Chenchen-0506/esp32-s4-fly/groundstation/_shots/S4Fly地面站_desktop.jpg

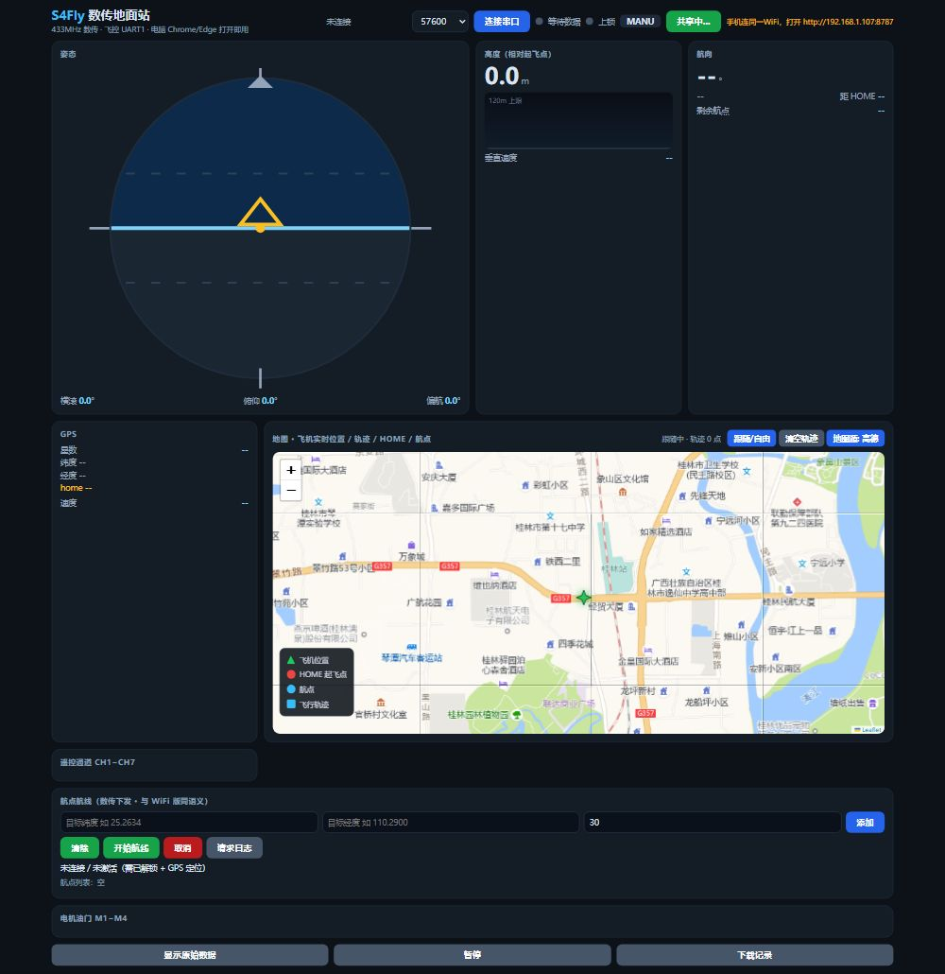
groundstation/_shots/S4Fly地面站_desktop.jpg
