Chenchen-0506/esp32-s4-fly/HARDWARE.md

# ESP32-S3 四旋翼 硬件清单与引脚说明书

> 版本：v0.25.1 · 配套固件：M6_full_flight（v0.25.1，iBus RMT 解码 / 数传缓冲 / LOGGER 落盘优化 / 返航丢星缓降）
> 更新日期：2026-10-20

---

## 一、硬件清单（BOM / 采购核对）

| # | 部件 | 规格 | 数量 | 状态/备注 |
|---|---|---|---|---|
| 1 | 飞控主控 | ESP32-S3 DevKitC N16R8（16MB Flash / 8MB PSRAM） | 1 | ✅ 已到货验证（真品自检通过） |
| 2 | 九轴 IMU | ICM-20948 模块（SPI 接口） | 1 | ✅ 已到货验证 |
| 3 | 气压计 | BMP280 模块（I2C） | 1 | ✅ 已到货验证 |
| 4 | GPS/罗盘 | BN-880 模块（GPS UART + 内置罗盘 I2C） | 1 | ✅ 已到货验证 |
| 5 | 遥控 | FlySky FS-i6 遥控器 + FS-iA6B 接收机 | 1 套 | ✅ 遥控（iBus 协议） |
| 6 | 电调 | 30A BLHeli 电调 | 4 | ✅ 已校准（BEC 红线全部挑出不接） |
| 7 | 电机 | 2212 KV920 无刷电机 | 4 | ✅ 转向已验证（对角同向） |
| 8 | 螺旋桨 | 1045 桨 | 4（建议备 4） | 装机/试飞前装 |
| 9 | 电池 | 4S 3000mAh LiPo | 1 | 满电 16.8V / 标称 14.8V |
| 10 | 降压电源 | 好盈 5V UBEC | 1 | 全机唯一 5V 源（空载 5.3V 正常） |
| 11 | 分电板 | PDB（4 路电调 + UBEC 焊盘） | 1 | ✅ 焊接测试通过 |
| 12 | 电源接头 | XT60 公/母头 | 1 套 | ✅ |
| 13 | 机架 | 3D 打印件（待打印 STL 包，含中心板/电机座/脚架等） | 1 套 | 全 3D 打印方案（无碳管） |
| 14 | 装配螺丝 | 机架/电机座装配用不锈钢螺丝 | 若干 | 规格以机架规格书为准 |
| 15 | 接线 | 杜邦线 / 信号线 / 硅胶线 | 若干 | 信号线 + 电源线分色 |
| 16 | 数传 | SDR X6 / 3DR 433MHz 数传（机载 + 地面套装） | 1 套 | GH1.25 自锁接口，需 GH1.25 转杜邦母头线（4P/5P）；模块可更换 |

> ⚠️ 采购核对时以本表 + 飞书 BOM 表为准；螺丝等紧固件规格详见机架规格书。

---

## 二、引脚分配表（ESP32-S3）

### 传感器与外设

| 外设 | 接口 | 引脚 | 参数 | 备注 |
|---|---|---|---|---|
| ICM-20948 | SPI | SCK=12 / MISO=13 / MOSI=11 / CS=10 | 8 MHz，MODE3 | 陀螺零偏开机自校 |
| BMP280 | I2C | SDA=8 / SCL=9 | 100kHz | 3.3V 供电；CSB 接 3V3 |
| BN-880 GPS | UART2 | RX=16 / TX=17 | 自动扫描 9600/38400/57600/115200 | 室外定位 |
| 内置罗盘 | I2C（同 BMP280） | SDA=8 / SCL=9 | QMC5883L 0x0D / HMC5883 0x1E | 返航必用，需磁校准；磁偏角 GPS 定位后自动识别（WMM 查表） |
| 数传 LINK | UART1 | TX=14 / RX=15 | 57600 8N1 | 机载数传模块（模块可更换） |

### 遥控（FS-iA6B / iBus）

| 功能 | 引脚 | 参数 |
|---|---|---|
| iBus 信号（接收机 i-BUS 口 → 飞控） | GPIO18 | 19200 baud 8N1，帧头 0x20 0x40；v0.25.1 起 RMT 硬件解码（不占用任何 UART；UART0=USB 串口、UART1=数传、UART2=GPS 全占用，切勿再接串口方案） |
| 接收机供电 | 5V（UBEC）+ GND 共地 | i-BUS 单针信号线即可 |

**通道映射**（iBus 通道顺序与遥控器一致）：

| 通道 | 功能 | 代码常量 | 说明 |
|---|---|---|---|
| CH1 | 横滚 | CH_ROLL | 右摇杆横 |
| CH2 | 俯仰 | CH_PITCH | 右摇杆纵 |
| CH3 | 油门 | CH_THROTTLE | 左摇杆纵 |
| CH4 | 偏航 | CH_YAW | 左摇杆横 |
| CH5 | 解锁/上锁 | CH_ARM | 开关：高=解锁（油门最低保持 2s） |
| CH6 | 返航/磁校准 | CH_RTL | 开关：高=返航；未解锁+低油门+CH6 高 3s=磁校准 |
| CH7 | 定高/悬停 | CH_POS | ⚠️ FS-iA6B 为 6 通道，**无物理 CH7**，悬停暂不可触发 |

### 电机与电调（PWM）

| 电机 | 信号引脚 | 电调接线 | 转向 |
|---|---|---|---|
| M1 | GPIO4 | 信号 + 地（BEC 红线挑出） | 与 M4 同向 |
| M2 | GPIO5 | 同上 | 与 M3 同向（与 M1 反向） |
| M3 | GPIO6 | 同上 | 与 M2 同向 |
| M4 | GPIO7 | 同上 | 与 M1 同向 |

- 信号：50Hz PWM，14bit 分辨率，1000µs=最低 / 2000µs=最高
- 电源：4 路电调正负极全部接分电板电源轨（4S 电池电压）

### 数传链路（LINK，UART1）

| 主控 | 机载数传（GH1.25 转杜邦线） |
|---|---|
| GPIO14 (TX) | RX |
| GPIO15 (RX) | TX |
| 5V | 5V |
| GND | GND |

- 波特率：**57600 8N1**（宏在 `src/LINK.h`，地面端选数传 COM + 57600）
- **模块可更换**：数传不是焊死部件，接 UART1（GPIO14/15 + 5V/GND）即可。任何 433MHz 数传模块（3DR、SDR X6 等），只要按上表接线、波特率 57600，**无需改动固件即可直接替换**。
- 更换注意：① TX↔RX 必须交叉；② 5V/GND 反接会烧模块，到货先用万用表核对 GH1.25 线序（不同商家颜色不统一）；③ 地面端数传用 USB 插电脑，配 3DR 调参软件或直接 57600 串口。
- 地面端页面：`groundstation/S4Fly地面站.html`（Web Serial 连接）

### 电源拓扑

```
电池(4S) → XT60 → 分电板正/负电源轨
                 ├── 电调1..4（动力电源）
                 └── UBEC(5V) → 飞控 5V / 接收机 5V / 传感器 3.3V(板载稳压)
```

- 全机**唯一 5V 源 = 好盈 UBEC**；电调 BEC 红线一律挑出热缩，禁止并接
- 板载 3.3V（ESP32-S3 自带稳压）供 ICM-20948 / BMP280 / 罗盘
- 安全铁律：**接电池时拔 USB；USB 烧录时不接电池；电调/电机通电前必拆桨**

---

## 三、装配检查清单（装机前）

- [ ] 分电板：XT60 正负不短路；正/负极到各电调焊盘导通；UBEC 输出 ≈5.0V
- [ ] 电调：四路行程已校准；自检哔 4 声（4S）；转向对角同向
- [ ] 电机：全部能平稳起转/停转，无异响
- [ ] 遥控：开机后 iBus 通道值正常（串口/仪表盘可见），CH5/CH6 开关有效
- [ ] 传感器：IMU 姿态正常、BMP 高度归零、GPS 室外定位、罗盘已校准（HOME 可记录）
- [ ] 紧固件：全部螺丝上紧、电机座/中心板无晃动、电池固定牢靠
- [ ] 桨：装机后首转前再次确认桨叶方向与电机转向匹配
