Chenchen-0506/esp32-s4-fly/groundstation/_shots/手机共享页面_desktop.jpg

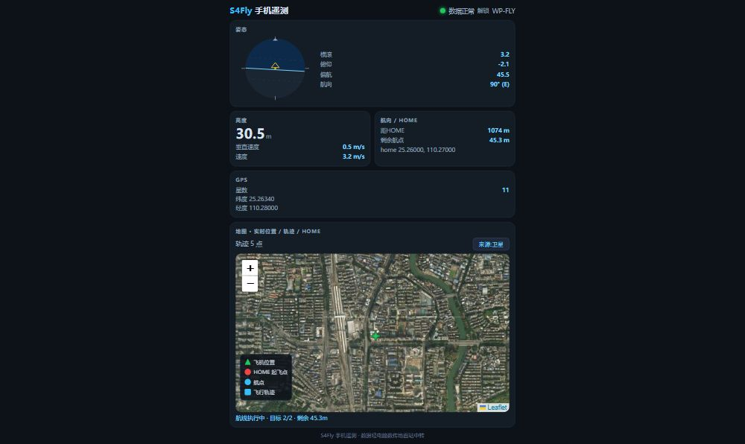
groundstation/_shots/手机共享页面_desktop.jpg
