Chenchen-0506/esp32-s4-fly/M6_full_flight/src/MAG.cpp

/*
 * ============================================================================
 * 罗盘功能模块实现 —— QMC5883L / HMC5883 自动识别 + 自动磁校准（NVS 持久化）
 *                 + 磁偏角自动识别（NOAA WMM 全球查表）
 * ============================================================================
 */
#include "MAG.h"
#include "MAG_DECL_TABLE.h"
#include <Wire.h>
#include <Preferences.h>

#define MAG_SDA  8
#define MAG_SCL  9
#define HMC_I2C_ADDR 0x1E
#define QMC_I2C_ADDR 0x0D
#define QMC_REG_X_LSB 0x00
#define QMC_REG_CTRL1 0x09

#define MAG_CAL_TIMEOUT_MS  30000UL   // 校准采样时长（30 秒）

// 磁偏角自动更新节流（GPS fix 后每 10s 查一次表）
#define MAG_DECL_UPDATE_MS  10000UL
// 磁偏角变化超过该值（度）才写 NVS（避免频繁写 flash）
#define MAG_DECL_SAVE_DELTA 0.2f

static uint8_t mag_addr = 0;       // 检测到的地址（0=未找到）
static bool    mag_is_hmc = false; // true=HMC5883, false=QMC5883L

// 运行时偏移（校准结果，NVS 持久化）
float mag_x_off = 0.0f;
float mag_y_off = 0.0f;

// 运行时磁偏角（GPS 定位后自动更新；NVS 持久化）
float mag_decl = MAG_DECL;
bool  mag_calibrated = false;

// ---- 校准采样状态 ----
static bool     cal_active = false;
static uint32_t cal_start_ms = 0;
static bool     cal_init = false;
static int16_t  cal_minx = 0, cal_maxx = 0;
static int16_t  cal_miny = 0, cal_maxy = 0;

bool mag_cal_done() { return mag_calibrated; }

bool mag_begin() {
  // Wire 已由主程序 setup 统一初始化（Wire.begin(8,9)），此处不再重复调用

  // 先试 HMC5883 (0x1E)
  Wire.beginTransmission(HMC_I2C_ADDR);
  if (Wire.endTransmission() == 0) {
    mag_addr = HMC_I2C_ADDR;
    mag_is_hmc = true;
    Wire.beginTransmission(HMC_I2C_ADDR);
    Wire.write(0x02);              // 模式寄存器
    Wire.write(0x00);              // 连续测量模式
    Wire.endTransmission();
    return true;
  }
  // 再试 QMC5883L (0x0D)
  Wire.beginTransmission(QMC_I2C_ADDR);
  if (Wire.endTransmission() == 0) {
    mag_addr = QMC_I2C_ADDR;
    mag_is_hmc = false;
    Wire.beginTransmission(QMC_I2C_ADDR);
    Wire.write(QMC_REG_CTRL1);
    Wire.write(0x01);              // 连续测量, 50Hz, 8x 过采样
    Wire.endTransmission();
    return true;
  }
  return false;
}

/* ---- 读取原始 X/Y/Z ---- */
static bool mag_read_raw(int16_t &x, int16_t &y, int16_t &z) {
  if (mag_addr == 0) return false;
  uint8_t base = mag_is_hmc ? 0x03 : QMC_REG_X_LSB;
  Wire.beginTransmission(mag_addr);
  Wire.write(base);
  Wire.endTransmission();
  Wire.requestFrom(mag_addr, (uint8_t)6);
  if (Wire.available() < 6) return false;

  if (mag_is_hmc) {
    // HMC5883：X MSB/LSB, Z MSB/LSB, Y MSB/LSB
    uint8_t xh = Wire.read(), xl = Wire.read();
    uint8_t zh = Wire.read(), zl = Wire.read();
    uint8_t yh = Wire.read(), yl = Wire.read();
    x = (int16_t)((xh << 8) | xl);
    y = (int16_t)((yh << 8) | yl);
    z = (int16_t)((zh << 8) | zl);
  } else {
    // QMC5883L：X LSB/MSB, Y LSB/MSB, Z LSB/MSB
    uint8_t xl = Wire.read(), xh = Wire.read();
    uint8_t yl = Wire.read(), yh = Wire.read();
    uint8_t zl = Wire.read(), zh = Wire.read();
    x = (int16_t)((xh << 8) | xl);
    y = (int16_t)((yh << 8) | yl);
    z = (int16_t)((zh << 8) | zl);
  }
  return true;
}

/* ---- NVS 加载/保存 ---- */
void mag_load_cal() {
  Preferences p;
  p.begin("mag", true);                  // 只读打开
  mag_x_off = p.getFloat("xoff", 0.0f);
  mag_y_off = p.getFloat("yoff", 0.0f);
  mag_decl  = p.getFloat("decl", MAG_DECL);
  mag_calibrated = (p.getUChar("caldone", 0) == 1);
  p.end();
}

static void mag_save_cal() {
  Preferences p;
  p.begin("mag", false);                 // 可写打开
  p.putFloat("xoff", mag_x_off);
  p.putFloat("yoff", mag_y_off);
  p.putUChar("caldone", 1);   // 校准完成标志（供地面站检查清单）
  p.end();
}

static void mag_save_decl() {
  Preferences p;
  p.begin("mag", false);
  p.putFloat("decl", mag_decl);
  p.end();
}

/* ---- 校准：开始 / 推进 / 提前结束 ---- */
void mag_cal_start() {
  cal_active = true;
  cal_start_ms = millis();
  cal_init = false;
}

int mag_cal_step() {
  if (!cal_active) return 0;
  int16_t mx, my, mz;
  if (mag_read_raw(mx, my, mz)) {
    if (!cal_init) {
      cal_init = true;
      cal_minx = cal_maxx = mx;
      cal_miny = cal_maxy = my;
    }
    if (mx < cal_minx) cal_minx = mx;
    if (mx > cal_maxx) cal_maxx = mx;
    if (my < cal_miny) cal_miny = my;
    if (my > cal_maxy) cal_maxy = my;
  }
  if (millis() - cal_start_ms >= MAG_CAL_TIMEOUT_MS) {
    mag_cal_finish();
    return 1;
  }
  return 0;
}

void mag_cal_finish() {
  if (cal_init) {
    mag_x_off = -((float)cal_maxx + cal_minx) / 2.0f;
    mag_y_off = -((float)cal_maxy + cal_miny) / 2.0f;
  }
  mag_save_cal();
  mag_calibrated = true;
  cal_active = false;
}

/* ---- 磁偏角自动识别（NOAA WMM 全球查表 + 双线性内插）---- */
float mag_auto_decl(float lat, float lon) {
  if (lat < -90.0f) lat = -90.0f;
  if (lat >  90.0f) lat =  90.0f;
  if (lon < -180.0f) lon = -180.0f;
  if (lon >  180.0f) lon =  180.0f;

  float fi = (lat + 90.0f) / 10.0f;      // 行索引（0..18）
  float fj = (lon + 180.0f) / 10.0f;     // 列索引（0..36）
  int i0 = (int)fi; if (i0 > 17) i0 = 17;
  int j0 = (int)fj; if (j0 > 35) j0 = 35;
  float di = fi - (float)i0;
  float dj = fj - (float)j0;

  float v00 = (float)mag_decl_table[i0][j0];
  float v10 = (float)mag_decl_table[i0 + 1][j0];
  float v01 = (float)mag_decl_table[i0][j0 + 1];
  float v11 = (float)mag_decl_table[i0 + 1][j0 + 1];

  float a = (1.0f - di) * v00 + di * v10;
  float b = (1.0f - di) * v01 + di * v11;
  return ((1.0f - dj) * a + dj * b) * 0.01f;   // int16 单位 0.01° → 度
}

/* GPS fix 后周期调用：查表更新磁偏角（节流 10s），变化 >0.2° 才持久化 */
void mag_auto_update(float lat, float lon) {
  static uint32_t tLast = 0;
  uint32_t now = millis();
  if (now - tLast < MAG_DECL_UPDATE_MS) return;
  tLast = now;

  float d = mag_auto_decl(lat, lon);
  if (d < -90.0f || d > 90.0f) return;   // 查表异常保护
  if (fabsf(d - mag_decl) > MAG_DECL_SAVE_DELTA) {
    mag_decl = d;
    mag_save_decl();
  } else {
    mag_decl = d;                        // 值几乎没变也同步，但不写 NVS
  }
}

/* ---- 读取航向（应用偏移 + 磁偏角）---- */
void mag_read(float &headingDeg) {
  int16_t mx, my, mz;
  if (!mag_read_raw(mx, my, mz)) { headingDeg = -1.0f; return; }
  float x = (float)mx + mag_x_off;
  float y = (float)my + mag_y_off;
  float h = atan2f(y, x) * 180.0f / PI + mag_decl;
  if (h < 0) h += 360.0f;
  if (h >= 360.0f) h -= 360.0f;
  headingDeg = h;
}
