Chenchen-0506/esp32-s4-fly/M6_full_flight/src/MAG_DECL_TABLE.h

/*
 * ============================================================================
 * 全球磁偏角查表（WMM 2025 模型采样，10° x 10° 网格，int16 单位 0.01°）
 * ----------------------------------------------------------------------------
 * 数据来源：NOAA World Magnetic Model（美国联邦政府作品，公共领域）
 * 结构：行 = 纬度 -90..+90 步 10°（19 行）；列 = 经度 -180..+180 步 10°（37 列）
 * 值 = 磁偏角（度 x 100，正值=东偏 / 负值=西偏）
 * 用法：双线性内插，见 MAG.cpp 的 mag_auto_decl()
 * ============================================================================
 */
#ifndef MAG_DECL_TABLE_H
#define MAG_DECL_TABLE_H

#include <stdint.h>

const int16_t mag_decl_table[19][37] = {
  14820, 13820, 12820, 11820, 10820, 9820, 8820, 7820, 6820, 5820, 4820, 3820, 2820, 1820, 820, -180, -1180, -2180, -3180, -4180, -5180, -6180, -7180, -8180, -9180, -10180, -11180, -12180, -13180, -14180, -15180, -16180, -17180, 17820, 16820, 15820, 14820,
  12850, 11640, 10538, 9528, 8593, 7714, 6877, 6070, 5282, 4508, 3745, 2989, 2238, 1490, 740, -19, -791, -1581, -2395, -3233, -4096, -4983, -5892, -6825, -7783, -8771, -9799, -10876, -12017, -13235, -14543, -15940, -17410, 17084, 15595, 14172, 12850,
  8586, 7792, 7147, 6595, 6094, 5615, 5130, 4618, 4068, 3479, 2861, 2232, 1609, 1006, 421, -159, -758, -1401, -2103, -2862, -3666, -4495, -5330, -6157, -6973, -7782, -8598, -9450, -10387, -11501, -12984, -15229, 17337, 13675, 11186, 9641, 8586,
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
  -16754, -15754, -14754, -13754, -12754, -11754, -10754, -9754, -8754, -7754, -6754, -5754, -4754, -3754, -2754, -1754, -754, 246, 1246, 2246, 3246, 4246, 5246, 6246, 7246, 8246, 9246, 10246, 11246, 12246, 13246, 14246, 15246, 16246, 17246, -17754, -16754
};


#endif /* MAG_DECL_TABLE_H */
