Chenchen-0506/esp32-s4-fly/(commit log)

2026-10-12 v0.0 基线快照：M1-M6 全部里程碑代码 + 板子/传感器自检
2026-10-12 v0.1-M6-modular：M6 主飞控模块化拆分（src/ 功能块：ICM20948/SBUS/PID/Motors），arduino-cli 编译通过
2026-10-12 v0.2 README：补充软件依赖章节，修正 M6 模块结构图
2026-10-12 v0.3 BMP280 模块：抽为 src/BMP280.h/.cpp（I2C 寄存器级驱动），接入 M6 高度采样与打印，编译通过
2026-10-14 v0.4 M7 返航功能：新增 GPS/MAG/RTL 模块，CH5 开关解锁上锁、CH6 手动返航、失控自动返航（无定位强制上锁），编译通过 364KB/27%
2026-10-14 v0.5 返航参数调整：home 改为起飞后 GPS 定位连续 1 分钟记录，返航高度 120m，距 home 5m 降落，编译通过
2026-10-14 v0.6 自检修复：GPS 解析改逐字符非阻塞（防控制环卡死 1s），CH5 上锁时清空返航状态（防残留导致再解锁续飞返航），编译通过 366KB/27%
2026-10-14 v0.7 罗盘自动磁校准：旋转采样自动算偏移并存 NVS（掉电不丢），CH6 拨高 3 秒进入（未解锁+油门最低），校准期间屏蔽解锁；MAG_DECL 默认 -2.5 桂林，编译通过 375KB/28%
2026-10-14 v0.8 定高+悬停：新增 ALTHOLD（ArduPilot AltHold 结构：高度误差->垂速->油门，悬停油门自适应）与 POSHOLD（Loiter 结构：位置误差->倾角+摇杆搬移目标点+航向锁定），CH7 高进入（返航/上锁/失控优先退出），无 GPS 时 CH7 仅定高，编译通过 377KB/28%
2026-10-14 v0.9 悬停油门自动学习（ArduPilot MOT_HOVER_LEARN 同款）：悬停稳定时自动收敛基准并每 10s 存 NVS，开机自动加载，飞几次无需手动调悬停油门，编译通过 378KB/28%
2026-10-14 v0.10 垂直融合+下降段位置修正：① 新增 VERTEST 模块（加速度+气压 1D 互补，垂速噪声降 5~10 倍，定高/触地更稳）；② RTL_DESCEND 保留水平位置修正（限幅 8°，落点收进 3m 内）；③ ALTHOLD 垂速改由融合提供。编译通过 378KB/28%
2026-10-14 v0.11 飞行黑匣子+WiFi实时看板：① LOGGER 模块（RAM 环形 512 行 + LittleFS /log.txt 落盘，60s 周期+上锁即存，串口发 D 导出，断电最多丢 1 分钟）；② TELEMETRY 模块（softAP 热点 S4Fly-Telemetry，手机浏览器 http://192.168.4.1 实时看数据+下载记录，飞行无需 USB）；③ 打印行同时进串口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
2026-10-14 v0.12 代码自检修复：① 修正加速度量程 bug（ACCEL_CONFIG=±16g 但 ACC_LSB_G 按 ±8g=4096，读数缩水一半，VERTEST 垂速错乱）→ ACC_LSB_G=2048 匹配 ±16g；② 失控保护不打断返航降落段（DESCEND/LANDED 中失控继续降落，禁止重爬 120m）；③ 解锁瞬间重记地面气压+垂直融合归零（防气压漂移导致高度基准偏）；④ 磁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
2026-10-14 README 补全至 v0.12：模块树新增 ALTHOLD/POSHOLD/VERTEST/LOGGER/TELEMETRY；功能说明更新（自动磁校准/定高悬停/黑匣子/WiFi 看板/失控降落保护/解锁重定高）；阶段回档标签补齐 v0.5~v0.12
2026-10-14 v0.12 补充：telemetry_poll 限流到 100Hz（原 1kHz 主环每环空转同步 WebServer handleClient，浪费 CPU）；浏览器 1s 轮询下 10ms 粒度足够
2026-10-15 v0.13 遥控 SBUS->iBus(FS-iA6B) + WiFi 仪表盘：SBUS模块改为iBus解析(19200 8N1 帧头0x20 0x40 校验和)；TELEMETRY新增/api JSON快照路由(10Hz填充姿态/高度/航向/GPS/RC/电机)，页面升级为仪表盘(姿态球+高度柱+航向+GPS卡+通道/电机条+日志保留)；M4_esc_test支持t命令四路同时自动测试；REA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
2026-10-15 v0.14 新增 HARDWARE.md 硬件清单与引脚说明书：15 项硬件清单(数量/规格/状态)、全外设引脚分配表(SPI/I2C/UART/iBus/PWM)、通道映射、电源拓扑、装机检查清单；README 加文档索引
2026-10-16 v0.15 新增 GPS 航点飞行（WiFi 网页下发坐标）：新建 WAYPOINT 模块(CLIMB->FLY->ARRIVED 状态机,复用 RTL 飞向目标控制)；主程序集成(优先级 RTL>WP>手动,遥控摇杆偏离立即退出,上锁/失控自动取消)；TELEMETRY 加航点面板与 /wp 路由,/api 加 wp 字段；README 同步
2026-10-16 v0.16 home 坐标实时上传 WiFi 仪表盘：RTL 暴露 home 经纬度 getter(rtl_home_lat/lon)；tel_status 加 homeLat/homeLon；/api JSON 与页面 GPS 卡显示 home 坐标(未记录时提示'起飞后定位 1 分钟生成')
2026-10-16 v0.17 多航点航线飞行 + 自绘俯视航图：WAYPOINT 升级为 8 航点列表,逐点爬升+飞抵+到点推进,全部飞完悬停(不返航)；/wp 路由 add/clear/start/stop；/api 加 wpIndex/wpTotal/wpList；页面航线面板(添加/清除/开始/取消+列表)与 SVG 航图(home 中心,航点/连线/飞机实时位置,无需外网)；README 同步
2026-10-16 README 新增功能总览表（v0.17，按感知/遥控/控制/自动飞行/安全/数据/工具/工程分类，含版本号）
2026-10-16 v0.18 全工程自检优化：VERTEST姿态补偿(四元数)、航点摇杆接管+GPS丢失取消、CH7不覆盖航点、GPS去String、LOG_LINE_LEN防截断
2026-10-16 README 新增后续计划（Roadmap）：433MHz数传+地面站、图传、定高触发待定
2026-10-17 新增数传地面站：电脑端Web Serial+多源地图+手机共享（中转服务器）
2026-10-17 修复共享服务器启动：服务器更名share_server.py+bat改全英文（中文文件名在cmd GBK下乱码导致启动失败）
2026-10-17 地面站增强：手机端地图源切换按钮(高德/卫星/OSM)+电脑端打开自动开启共享+服务器启动自动打开地面站
2026-10-17 排除自检截图目录_shots（过程产物不入库）
2026-10-17 地图源仅保留高德/卫星(两端)+定位修复：标记收到遥测才显示+高精度定位，消除默认坐标误导
2026-10-17 卫星地图源换高德影像(style=7)：修复国外Esri源加载失败导致电脑端切不到卫星的问题
2026-10-17 电脑端加回Esri卫星源(手机之前同款)，与高德影像并存三源切换
2026-10-17 修复电脑端地图源无法选择：switchTileSource挂到window+改为高德/卫星/Esri卫星三按钮直选，放宽自动兜底阈值
2026-10-17 地图源收敛为两源：两端删高德影像卫星，手机端卫星改回Esri(与电脑端一致)
2026-10-17 数传链路落地：LINK模块(UART1 57600) 10Hz JSON遥测上行+WP/D命令下行,USB同路输出,TELEMETRY提取共用函数,README同步
2026-10-17 无GPS失控缓降：丢信号无定位时怠速缓降(1150us)而非直接停桨,触地(0.6m)/15s超时自动上锁,信号恢复退出缓降,模式显示GLIDE
2026-10-17 vspd/spd遥测字段+数传网页记录CSV导出：固件补垂直速度(vertest_vel)与地速(GPS差分),电脑/手机地面站自动记录遥测并导出CSV(替换完整日志下载为网页记录分析通道),README v0.19
2026-10-17 代码自检与清理：删除未使用函数 mag_cal_active/wp_begin,修复WiFi网页航点命令大小写不兼容(400)问题(tel_wp_cmd统一大写归一化),--warnings all 编译零警告
2026-10-17 README版本号对齐：功能总览 v0.20.1, 网页记录/CSV行 v0.20(与v0.19数传/v0.20遥测tag对应)
2026-10-19 新增MIT License并同步README：许可证章节+修正Roadmap数传状态(已v0.19~v0.20)
2026-10-19 HARDWARE.md升级v0.21：补数传引脚(UART1 GPIO14/15 57600)与模块可更换说明,BOM加数传套装,README与主程序头注释同步
2026-10-19 README：航点网页命令路由改写成清晰列表并注明大小写兼容
2026-10-19 v0.21 磁偏角自动识别：内置NOAA WMM全球查表(MAG_DECL_TABLE.h 10°网格+双线性内插)，GPS定位后自动更新并NVS持久化，遥测新增magDecl字段
2026-10-19 README全面同步v0.21：失控缓降/磁偏角自动/模块树补WAYPOINT与查表/阶段回档补全v0.14~v0.21(按实际tag)/HARDWARE引用v0.22
2026-10-19 v0.21.1 地面站中文状态徽章：GPS搜索中/待起飞/磁校准/返航各阶段/航点/失控缓降/位置悬停/无GPS，电脑端+手机端
2026-10-19 v0.21.2 地面站遥控通道区改显示CH5/CH6功能：标签中文化+实时状态(解锁生效/拨高触发)+操作说明行
2026-10-19 v0.21.3 状态徽章常驻：未连接时显示灰色[未连接]而非空占位，电脑端+手机端
2026-10-19 v0.21.4 地面站日志窗默认展开+占位提示，未连接时也能看到数据显示区
2026-10-19 v0.21.5 删除顶栏左侧串口连接状态文字(connState)，连接失败信息并入linkTxt
2026-10-19 v0.21.6 CSV导出补magDecl列(25列)，地面站功能逻辑自检通过
2026-10-19 v0.21.7 README更新：新增快速开始(安装教程)+地面站使用教程(连接/界面/状态徽章/航点/共享/CSV导出/FAQ)，版本记录补v0.21.1~v0.21.6
2026-10-19 v0.21.8 飞行轨迹回放：导入CSV→地图回放(播放/暂停/重置/1x-8x/进度拖动)，飞机方向箭头+HOME标记+全轨迹灰线+已飞蓝线，参数面板(模式/高度/速度/航向/GPS/距HOME/航点/油门)
2026-10-19 v0.22 遥控信号质量(帧接收率rssi)+磁校准标志(magCal)遥测：地面站信号条/起飞检查清单(全绿提示可起飞)/声音报警(失控缓降/断连/超时/校准完成)，README同步
2026-10-19 v0.23 参数在线调整：PARAM模块(30项PID/定高/返航参数,NVS持久化)+PARAM:SET/GET/RESET命令(数传/串口/WiFi通用)+地面站参数面板(读取/编辑/应用/恢复默认)，README同步
2026-10-19 v0.24 地面站UI调整：删除电机油门M1-M4区域，参数在线调整面板拉满宽度(按页面宽度多列排布)，参数名改为中文显示(key保留小字对照)，修复PARAM按钮引号嵌套与回执切片偏移
2026-10-19 v0.24.1 连接串口后自动读取参数当前值(PARAM:GET)，无需手动点读取
2026-10-19 v0.24.2 修复grid未闭合导致logbar/日志窗被压缩成一列的问题，日志窗高度150->300px
2026-10-19 v0.25 selfcheck-fix：iBus移UART0(GPIO44)防串口冲突 / 数传发送缓冲防阻塞1kHz环 / WP:ADD高度解析修复 / RTL巡航参数统一 / LOGGER飞行中不落盘+环形修正 / 死代码清理，README与HARDWARE同步
2026-10-19 v0.25.1 rmt-failsafe：iBus改RMT硬件解码(GPIO18不变、不占用UART，废弃UART0方案) + 返航中GPS丢星强制缓降上锁 + 地面站调参面板应用按钮布局修复
